cartagena/InkyCase/(commit log)

2026-08-27 Add OpenSCAD port, PCB hardware reference, and updated CLAUDE.md
    The Fusion script now has a Fusion-free OpenSCAD twin (impression-7.3/openscad-script.scad)
    that can be validated and exported to STL from the CLI. PCB_REFERENCE.md compiles
    Pimoroni's spec/drawing into a confidence-rated hardware reference, which fixed two
    real numbers in the design (display window borders and PCB post placement/count).
    CLAUDE.md is updated to describe both scripts and the new derivation rules.
    [openscad-script.scad]
2026-08-28 Fixed buttons
    [openscad-script.scad]
